altay-brusan/water-tank-telemeter/Hardware/Design/Water Tank Telemeter.html

Altium customize

# Board Information Report

Date: | | 7/1/2020
Time: | | 11:07:46 PM
Elapsed Time: | | 00:00:00
Filename: | | D:\[PieVision]\Sync\[PROJECTS]\Design Files\PieVision\WTT\V1I1\Water Tank Telemeter.PcbDoc

## Contents

Contents
