altay-brusan/water-tank-telemeter/Hardware/Design/Water Tank Telemeter.PcbDoc.htm

Reporting Options

# File in Previous Format

Date | : | 1/22/2021
Time | : | 12:21:04 PM
Filename | : | D:\embedded_systems\Projects\Pievision\WTT\Design\Water Tank Telemeter.PcbDoc

Version | Warning

This file was generated by an earlier version of the software
