altay-brusan/water-tank-telemeter/Hardware/Assets/Checkout order.docx

Check order:

1- Visual inspection

Rust

Dust

Corrosion

Components drop

Back plane

Water drops

2- 12V input ripple measurement with oscilloscope

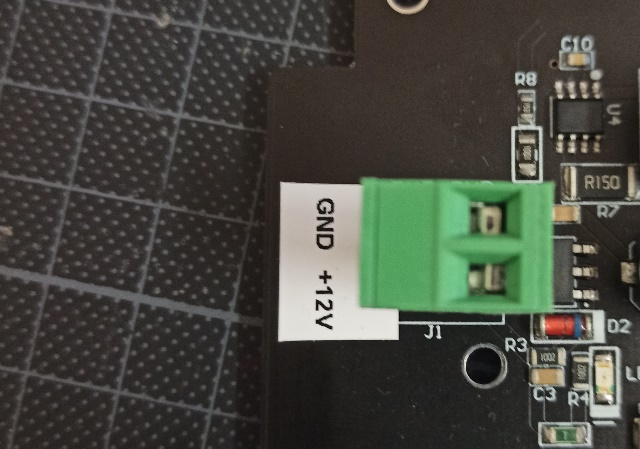
[picture p2: figure]

3- 3.3V 3.8V and 20V test point measurement

TP4: 20V

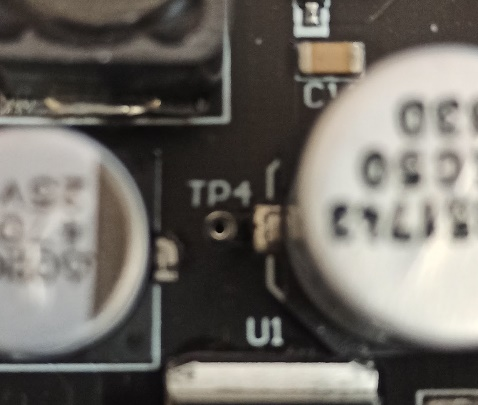
[picture p3: figure]

TP1: 5.3V TP2:3.8 TP3:3.3V

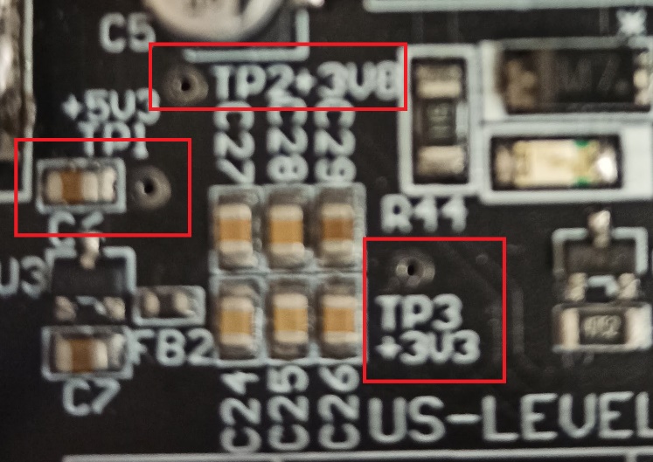
[picture p4: figure]

TP5: GND

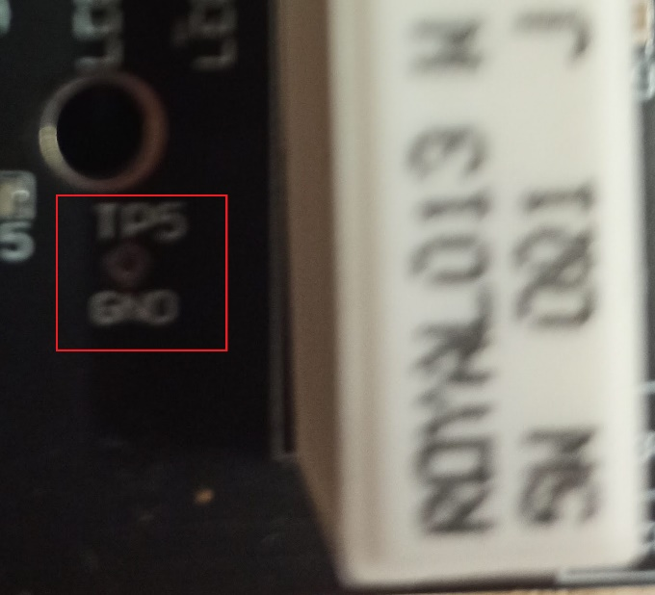
[picture p5: figure]

4- GOSUNCN external power: this pin should provide 2.7V

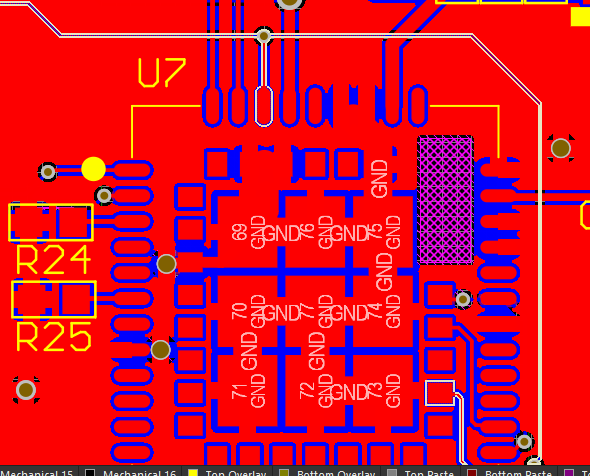
[picture p6: figure]

5- UART Monitoring

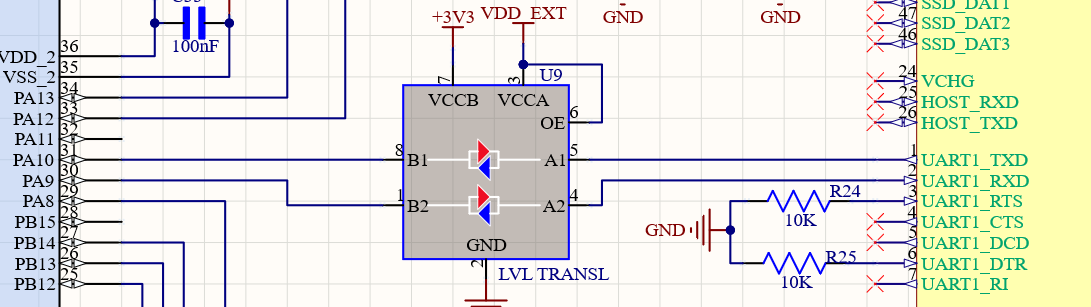
[picture p7: figure]
