altay-brusan/water-tank-telemeter/Hardware/Release/PCB Manufacturing/Water Tank Telemeter BOM.xlsx

Comment | Designator | Quantity | Product Name | Product Description | Footprint
100uF | C1, C13 | 2 | BXJ63VC100MJ10TP | CAP.EL.100uF 63V 10x10 105C 5000Hrs SMD | CAP_AL_1010
470uF | C2, C8 | 2 | BDS25VC470MJ10TP | CAP.EL.470uF 25V 10x10 105C 2000Hrs SMD ±20%, CAP.EL.470uF 25V 10x10 105C 2000Hrs SMD | CAP_AL_1010
10nF | C3, C14, C15, C16, C24, C25 | 6 | CL21C103JBFNNNE | MLCC (2012) 0805 10nF 50VDC ±5% C0G (NP0) | CAP_0805
330nF | C4 | 1 | CL21B334KOCNNNC | MLCC (2012) 0805 330nF 16VDC ±10% X7R | CAP_0805
10uF | C5 | 1 | SC1V106M05005VR | CAP.EL.10uF 35V 5x5.3 85C SMD SAMWHA | CAP_AL_0553
1uF | C6, C7, C18, C23, C29 | 5 | CL21F105ZBFNNNE | MLCC (2012) 0805 1uF 50VDC -20% +80% Y5V | CAP_0805
100nF | C9, C11, C26, C27, C28, C30, C33, C34, C35, C37, C38, C39, C40, C41, C42, C43, C44, C45, C46, C47, C48, C49 | 22 | CL21B104JBCNNNC | MLCC (2012) 0805 100nF 50VDC ±5% X7R | CAP_0805
2.2nF | C10 | 1 | CL21B222JBANNNC | MLCC (2012) 0805 2.2nF 50VDC ±5% X7R | CAP_0805
330uF | C12 | 1 | LQ1H337M10020PA | CAP.EL.330uF 50V 10x20 105C 10000H TB | CAP_AL_THT_10X20X5MM
33pF | C17 | 1 | CL21C330GBANNNC | MLCC (2012) 0805 33pF 50VDC ±2% C0G (NP0) | CAP_0805
100uF | C19 | 1 | T491B107K006AT | CAP.TANTAL 100uF 6.3V 10% B CASE (3528) SMD KEMET | CAP_TANT_CASEB
1000uF | C20 | 1 | BXJ6.3VC1000MH10TP | CAP.EL.1000uF 6V3 8x10 105C 5000Hrs SMD | CAP_AL_0810
22pF | C21, C22 | 2 | CL21C220JBANNNC | MLCC (2012) 0805 22pF 50VDC ±5% C0G (NP0) | CAP_0805
20pF | C31, C32 | 2 | CL21C200JBANNNC | MLCC (2012) 0805 20pF 50VDC ±5% C0G (NP0) | CAP_0805
4.7uF | C36 | 1 | CL21A475KAQNNNE | MLCC (2012) 0805 4.7uF 25VDC ±10% X5R | CAP_0805
S6M | D1, D8 | 2 | S6M-DC | DIODE 6A 1000V SMT DO214AB (SMC) | DO-214AB
ZM4740 | D2, D3, D4 | 3 | ZM4740A-HT | DIODE ZENER 1W 10V ±5% LL-41 (MELF) SMT | MELF
SR35_R2_00001 | D5 | 1 | SR35_R2_00001 | DIODE SCHOTTKY 3A 50V DO214AA SMB PANJIT | DO214AA
B5819 | D6 | 1 | B5819W | DIODE SCHOTTKY 1A 40V SOD123 | SOD123
ZM4751 | D7 | 1 | ZM4751A-HT | DIODE ZENER 1W 30V ±5% LL-41 (MELF) SMT | MELF
M7_R2_00001 | D17, D18, D19, D20 | 4 | M7_R2_00001 | DIODE STAND. Single 1A 1000V SMT DO214AC (SMA) | DID_SMA
SM05T1G | D21, D22, D23, D24 | 4 | SM05T1G | DIODE TVS 5VWM 9.8VC SOT23 | SOT-23
1206SFS600F | F1, F2 | 2 | 1206SFS600F/24-2 | FUSE BOARD MOUNT 6A 24VDC 1206 | FUS_1206
33R | FB1, FB2, FB3, FB5 | 4 | BLM18PG330SN1D | FERRITE BEAD 0603 33R 3A MURATA | FB_0603
KF2EDG | J1, J2, J3 | 3 | KF2EDG-5.08-2P-14 | TERM.BLK.5.08MM 2P FEMALE GREEN | TERM_BLK_2P_F
SMA | J4 | 1 | L-KLS1-SMA045 | CONNECTOR SMA 5PIN THT R/A 8x8x14.8MM | CONN_SMA_H
Nano SIM Card Connector, Push & Pull | J5 | 1 | 115U-A000 | CONNECTOR NANO SIM CARD PUSH PULL 6PIN H:1.2MM | SOC_NSIM
Screw Ter. Blk. | J6, J7 | 2 | GT301-5.0-12P-12-00AH | TERM.BLK.5.00MM 12P PCB TYPE | TERM_BLK_12P
JW2SN | K1, K2, K3, K4 | 4 | JW2SN-DC12V | RELAY POWER 5A 12VDC 2P PANASONIC | RELAY_DPDT
100uH | L1, L2 | 2 | SRI1207-101M | INDUCTOR POWER 100UH 12X12X8MM SMD | IND_1212
HL-PC | LED1, LED2, LED3, LED5, LED8, LED9, LED10, LED11 | 8 | HL-PC-3216S9AC | LED SMD 1206 RED WATER CLEAR 90-120 mcd 140C | LED_RED_1206
HL-PC | LED4, LED7 | 2 | HL-PC-3216U51GC | LED SMD 1206 GREEN WATER CLEAR 600-800mcd | LED_GREEN_1206
HL-PC | LED6 | 1 | HL-PC-3216S29YC | LED SMD 1206 YELLOW WATER CLEAR 90-120mcd 140C | LED_YELLOW_1206
HDR_4X2 | P1 | 1 |  | Header, 4-Pin, Dual row | HDR2X4
MIC Connector | P2 | 1 |  |  | CONN_MIC_5P
NDT3055L | Q1, Q2, Q3 | 3 | NDT3055L | MOSFET DIS.4A 60V N-CH SOT223 ENHANCEMENT SMT | SOT223
BC327 | Q4 | 1 | BC327-40ZL1G | TRANSISTOR DIS.500mA 50V PNP TO92 AMP THT TRANSISTOR DIS.500mA 50V PNP TO92 AMP THT | TO-92
UTM2054G | Q5, Q6, Q7 | 3 | UTM2054G-AE3-R | MOSFET DIS.5A 20V N-CH SOT23 ENHANCEMENT SMT | SOT-23
ZXMN3A | Q9, Q10, Q11, Q12 | 4 | ZXMN3A01FTA | MOSFET DIS.1.8A 30V N-CH SOT23 ENHANCEMENT SMT | SOT-23
1K | R1, R6 | 2 | 0805S8F1001T5E, 0805S8J0102T5E | RES.(2012) 0805 1K Ohms 1% 1/8W-S 100PPM, RES.(2012) 0805 1K Ohms 5% 1/8W-S 100PPM | RES_0805
3.3K | R2 | 1 | 0805S8F3301T5E | RES.(2012) 0805 3.3K Ohms 1% 1/8W-S 100PPM | RES_0805
10K | R3, R4, R20, R21, R22, R24, R25, R34 | 8 | 0805S8F1002T5E, 0805S8J0103T5E | RES.(2012) 0805 10K Ohms 1% 1/8W-S 100PPM, RES.(2012) 0805 10K Ohms 5% 1/8W-S 100PPM | RES_0805
2.1K | R5 | 1 | 0805S8F2101T5E | RES.(2012) 0805 2.1K Ohms 1% 1/8W-S 100PPM | RES_0805
150mR | R7 | 1 | HP122WF150LT4E | RES.(6432) 2512 150m Ohms 1% 2W 200PPM | RES_2512
15K | R8 | 1 | 0805S8J0153T5E | RES.(2012) 0805 15K Ohms 5% 1/8W-S 100PPM | RES_0805
1K | R9 | 1 | 1206S4F1001T5E | RES.(3216) 1206 1K Ohms 1% 1/4W-S 100PPM | RES_1206
100R | R10 | 1 | PRW05WJP101B00 | RES.CEMENT 5W 100 Ohms 5% THT | RES_AXL_22X9
3.3R | R11 | 1 | RC2012F3R3CS | RES.(2012) 0805 3.3 Ohms 1% 1/8W +300PPM~-200PPM | RES_0805
220R | R12 | 1 | ERJ-P06D2200V | RES.(2012) 0805 220 Ohms 0.5% 1/2W 100PPM | RES_0805
2.7K | R13 | 1 | 0805S8F2701T5E | RES.(2012) 0805 2.7K Ohms 1% 1/8W-S 100PPM | RES_0805
1.5K | R14 | 1 | 0805S8F1501T5E | RES.(2012) 0805 1.5K Ohms 1% 1/8W-S 100PPM | RES_0805
100R | R15 | 1 | 0805S8F1000T5E | RES.(2012) 0805 100 Ohms 1% 1/8W-S 200PPM | RES_0805
4.7K | R16, R17 | 2 | 0805S8J0472T5E | RES.(2012) 0805 4.7K Ohms 5% 1/8W-S 100PPM | RES_0805
1.8K | R18, R19 | 2 | 0805S8J0182T5E | RES.(2012) 0805 1.8K Ohms 5% 1/8W-S 100PPM | RES_0805
49.9R | R23 | 1 | TC0325D499JT5C | RES.(1608) 0603 49.9 Ohms 0.5% 1/16W 25PPM | RES_0603
22R | R26, R27, R28 | 3 | CQ05S8F220JT5E | RES.(2012) 0805 22 Ohms 1% 1/8W-S AUTOMOTIV | RES_0805
47.5K | R29, R30, R35, R37, R38, R39, R40 | 7 | 0805S8F4752T5E | RES.(2012) 0805 47.5K Ohms 1% 1/8W-S 100PPM | RES_0805
150R | R31, R32 | 2 | 0805S8J0151T5E | RES.(2012) 0805 150 Ohms 5% 1/8W-S 100PPM | RES_0805
130R | R33, R45, R46, R47, R48, R49, R50, R51, R52 | 9 | 0805S8J0131T5E | RES.(2012) 0805 130 Ohms 5% 1/8W-S 100PPM | RES_0805
510R | R41, R42, R43, R44 | 4 | 1206S4J0511T5E | RES.(3216) 1206 510 Ohms 5% 1/4W-S 100PPM | RES_1206
200R | R53, R54, R55, R56, R57, R58, R59, R60 | 8 | CQ06W4F2000T5E | RES.(3216) 1206 200 Ohms 1% 1/4W-S AUTOMOTIV | RES_1206
330R | R61, R62, R63, R64, R65, R66, R67, R68 | 8 | CQ06W4F3300T5E | RES.(3216) 1206 330 Ohms 1% 1/4W-S AUTOMOTIV | RES_1206
SWC | SW1 | 1 | DTSMF-31R-V-T/R | SWITCH TACT 6x3.5MM 4.3MM 260gf SMD DIPTRONICS | TAC_0603_VT
P2576L-ADJ | U1 | 1 | P2576L-AD-TQ5-R | IC-2576 V.REG.3A ADJ SIMPL.STEP-DOWN SMD TO-263 | TO170P1435X465-6N
LD29300 | U2 | 1 | LD29300P2MTR | IC-29300 REG. LDO. ADJ 3A P2PAK/A | D2PAK/A
3.3V | U3 | 1 | MCP1700T-3302E/TT | IC-1700 REG LDO 3.3V 0.25A SOT23-3 | SOT-23
NCV3063 | U4 | 1 | NCV3063DR2G | IC-3063 INV. SWITCHING REGULATORS SOIC8 SMD ONS | SOIC-8
LM317T | U5 | 1 | LM317T-DG | IC-317 V.REG/STABILIZER 1.5A TO220 DOUBLE GAUG ST | TO-220AB
TL071CDR | U6 | 1 | TL071CDR | IC-071 OPAMP JFET 3MHZ SOIC8 | SOIC-8
MG2609 | U7 | 1 | HZ-MG2609-C1B-MK-01 | MODULE GSM/GPRS + ( OPTIONAL )GNSS | LCC_17P6X15P7X2P3
STM32F103C8T7 | U8 | 1 | STM32F103C8T7TR |  | LQFP-48
LVL TRANSL | U9 | 1 | TXB0102DCUR | IC-102 VOLT-LVL TRANSL BI-DIR US8 | VSSOP8
ESDA6V | U10 | 1 | ESDA6V1BC6 | DIODE TVS 80W 5V SOT23 SMD | SOT23-6L
ST3222BTR | U11 | 1 | ST3222BTR | IC-3222 DRIVER/RCVR RS232 LP 20-TSSOP | TSSOP20
LTV-217 | U12, U13, U14, U15, U16, U17, U18, U19 | 8 | LTV-217-B-G | IC-217 OPTO. 3750V SSOP4 | SSOP-4
8MHZ | Y1 | 1 | AS-8.000-20-H35 | CRYSTAL 8MHZ HC49S 20pF 30ppm SHORT BULK RALTRON | CRYS_THT
