altay-brusan/water-tank-telemeter/Hardware/Design/Project Outputs for Water Tank Telemeter/Water Tank Telemeter.xlsx

Comment | Designator | Footprint | LibRef | Quantity
100uF | C1, C13 | CAP_AL_1010 | CAP_AL_1010 | 2
470uF | C2, C8 | CAP_AL_1010 | CAP_AL_1010 | 2
10nF | C3, C14, C15, C16, C24, C25 | CAP_0805 | CAP_0805 | 6
330nF | C4 | CAP_0805 | CAP_0805 | 1
10uF | C5 | CAP_AL_0553 | CAP_AL_0553 | 1
1uF | C6, C7, C18, C23, C29 | CAP_0805 | CAP_0805 | 5
100nF | C9, C11, C26, C27, C28, C30, C33, C34, C35, C37, C38, C39, C40, C41, C42, C43, C44, C45, C46, C47, C48, C49 | CAP_0805 | CAP_0805 | 22
2.2nF | C10 | CAP_0805 | CAP_0805 | 1
330uF | C12 | CAP_AL_THT_10X20X5MM | CAP_AL_THT_10X12X5MM | 1
33pF | C17 | CAP_0805 | CAP_0805 | 1
100uF | C19 | CAP_TANT_CASEB | CAP_TANT_CASEB | 1
1000uF | C20 | CAP_AL_0810 | CAP_AL_0810 | 1
22pF | C21, C22 | CAP_0805 | CAP_0805 | 2
20pF | C31, C32 | CAP_0805 | CAP_0805 | 2
4.7uF | C36 | CAP_0805 | CAP_0805 | 1
S6M | D1, D8 | DO-214AB | DID_DO214 | 2
ZM4740 | D2, D3, D4 | MELF | DID_ZEN_MELF | 3
SR35_R2_00001 | D5 | DO214AA | D_SCK_DO214AA | 1
B5819 | D6 | SOD123 | DID_SCHK_SOD123 | 1
ZM4751 | D7 | MELF | DID_ZEN_MELF | 1
M7_R2_00001 | D17, D18, D19, D20 | DID_SMA | DID_SMA | 4
SM05T1G | D21, D22, D23, D24 | SOT-23 | TVS_SOT23 | 4
1206SFS600F | F1, F2 | FUS_1206 | FUZ_SMD_1206 | 2
33R | FB1, FB2, FB3, FB5 | FB_0603 | FB_0603 | 4
KF2EDG | J1, J2, J3 | TERM_BLK_2P_F | TERM_BLK_2POS_F | 3
SMA | J4 | CONN_SMA_H | SMA_RA | 1
Nano SIM Card Connector, Push & Pull | J5 | SOC_NSIM | SOC_NSIM | 1
Screw Ter. Blk. | J6, J7 | TERM_BLK_12P | TERM_BLK_12POS | 2
JW2SN | K1, K2, K3, K4 | RELAY_DPDT | REL_DPDT_12V | 4
100uH | L1, L2 | IND_1212 | IND_1212 | 2
HL-PC | LED1, LED2, LED3, LED5, LED8, LED9, LED10, LED11 | LED_RED_1206 | LED_RED_1206 | 8
HL-PC | LED4, LED7 | LED_GREEN_1206 | LED_GREEN_1206 | 2
HL-PC | LED6 | LED_YELLOW_1206 | LED_YELLOW_1206 | 1
HDR_4X2 | P1 | HDR2X4 | HDR_4X2 | 1
MIC Connector | P2 | CONN_MIC_5P | CONN_MIC_5P | 1
NDT3055L | Q1, Q2, Q3 | SOT223 | MOSFET_N_SOT223 | 3
BC327 | Q4 | TO-92 | BJT_PNP_THT_CBE | 1
UTM2054G | Q5, Q6, Q7 | SOT-23 | MOSFET_N_SOT23 | 3
ZXMN3A | Q9, Q10, Q11, Q12 | SOT-23 | MOSFET_N_SOT23 | 4
1K | R1, R6 | RES_0805 | RES_0805 | 2
3.3K | R2 | RES_0805 | RES_0805 | 1
10K | R3, R4, R20, R21, R22, R24, R25, R34 | RES_0805 | RES_0805 | 8
2.1K | R5 | RES_0805 | RES_0805 | 1
150mR | R7 | RES_2512 | RES_2512 | 1
15K | R8 | RES_0805 | RES_0805 | 1
1K | R9 | RES_1206 | RES_1206 | 1
100R | R10 | RES_AXL_22X9 | RES_AXL_20X9 | 1
3.3R | R11 | RES_0805 | RES_0805 | 1
220R | R12 | RES_0805 | RES_0805 | 1
2.7K | R13 | RES_0805 | RES_0805 | 1
1.5K | R14 | RES_0805 | RES_0805 | 1
100R | R15 | RES_0805 | RES_0805 | 1
4.7K | R16, R17 | RES_0805 | RES_0805 | 2
1.8K | R18, R19 | RES_0805 | RES_0805 | 2
49.9R | R23 | RES_0603 | RES_0603 | 1
22R | R26, R27, R28 | RES_0805 | RES_0805 | 3
47.5K | R29, R30, R35, R37, R38, R39, R40 | RES_0805 | RES_0805 | 7
150R | R31, R32 | RES_0805 | RES_0805 | 2
130R | R33, R45, R46, R47, R48, R49, R50, R51, R52 | RES_0805 | RES_0805 | 9
510R | R41, R42, R43, R44 | RES_1206 | RES_1206 | 4
200R | R53, R54, R55, R56, R57, R58, R59, R60 | RES_1206 | RES_1206 | 8
330R | R61, R62, R63, R64, R65, R66, R67, R68 | RES_1206 | RES_1206 | 8
SWC | SW1 | TAC_0603_VT | TACT_SMD_VT_6MM | 1
P2576L-ADJ | U1 | TO170P1435X465-6N | P2576L-AD-TQ5-R | 1
LD29300 | U2 | D2PAK/A | LD29300 | 1
3.3V | U3 | SOT-23 | MCP1700 | 1
NCV3063 | U4 | SOIC-8 | NCV3063DR2G | 1
LM317T | U5 | TO-220AB | LM317T | 1
TL071CDR | U6 | SOIC-8 | TL071CDR | 1
MG2609 | U7 | LCC_17P6X15P7X2P3 | MG2609 | 1
STM32F103C8T7 | U8 | LQFP-48 | STM32F103C8T7 | 1
LVL TRANSL | U9 | VSSOP8 | TXB0102DCUR | 1
ESDA6V | U10 | SOT23-6L | TVS_SOT236 | 1
ST3222BTR | U11 | TSSOP20 | TRANS_RS232 | 1
LTV-217 | U12, U13, U14, U15, U16, U17, U18, U19 | SSOP-4 | OPTCOP | 8
8MHZ | Y1 | CRYS_THT | CRYS-THT | 1
