altay-brusan/water-tank-telemeter/Hardware/Release/Schematic Diagrams/schematics.PDF

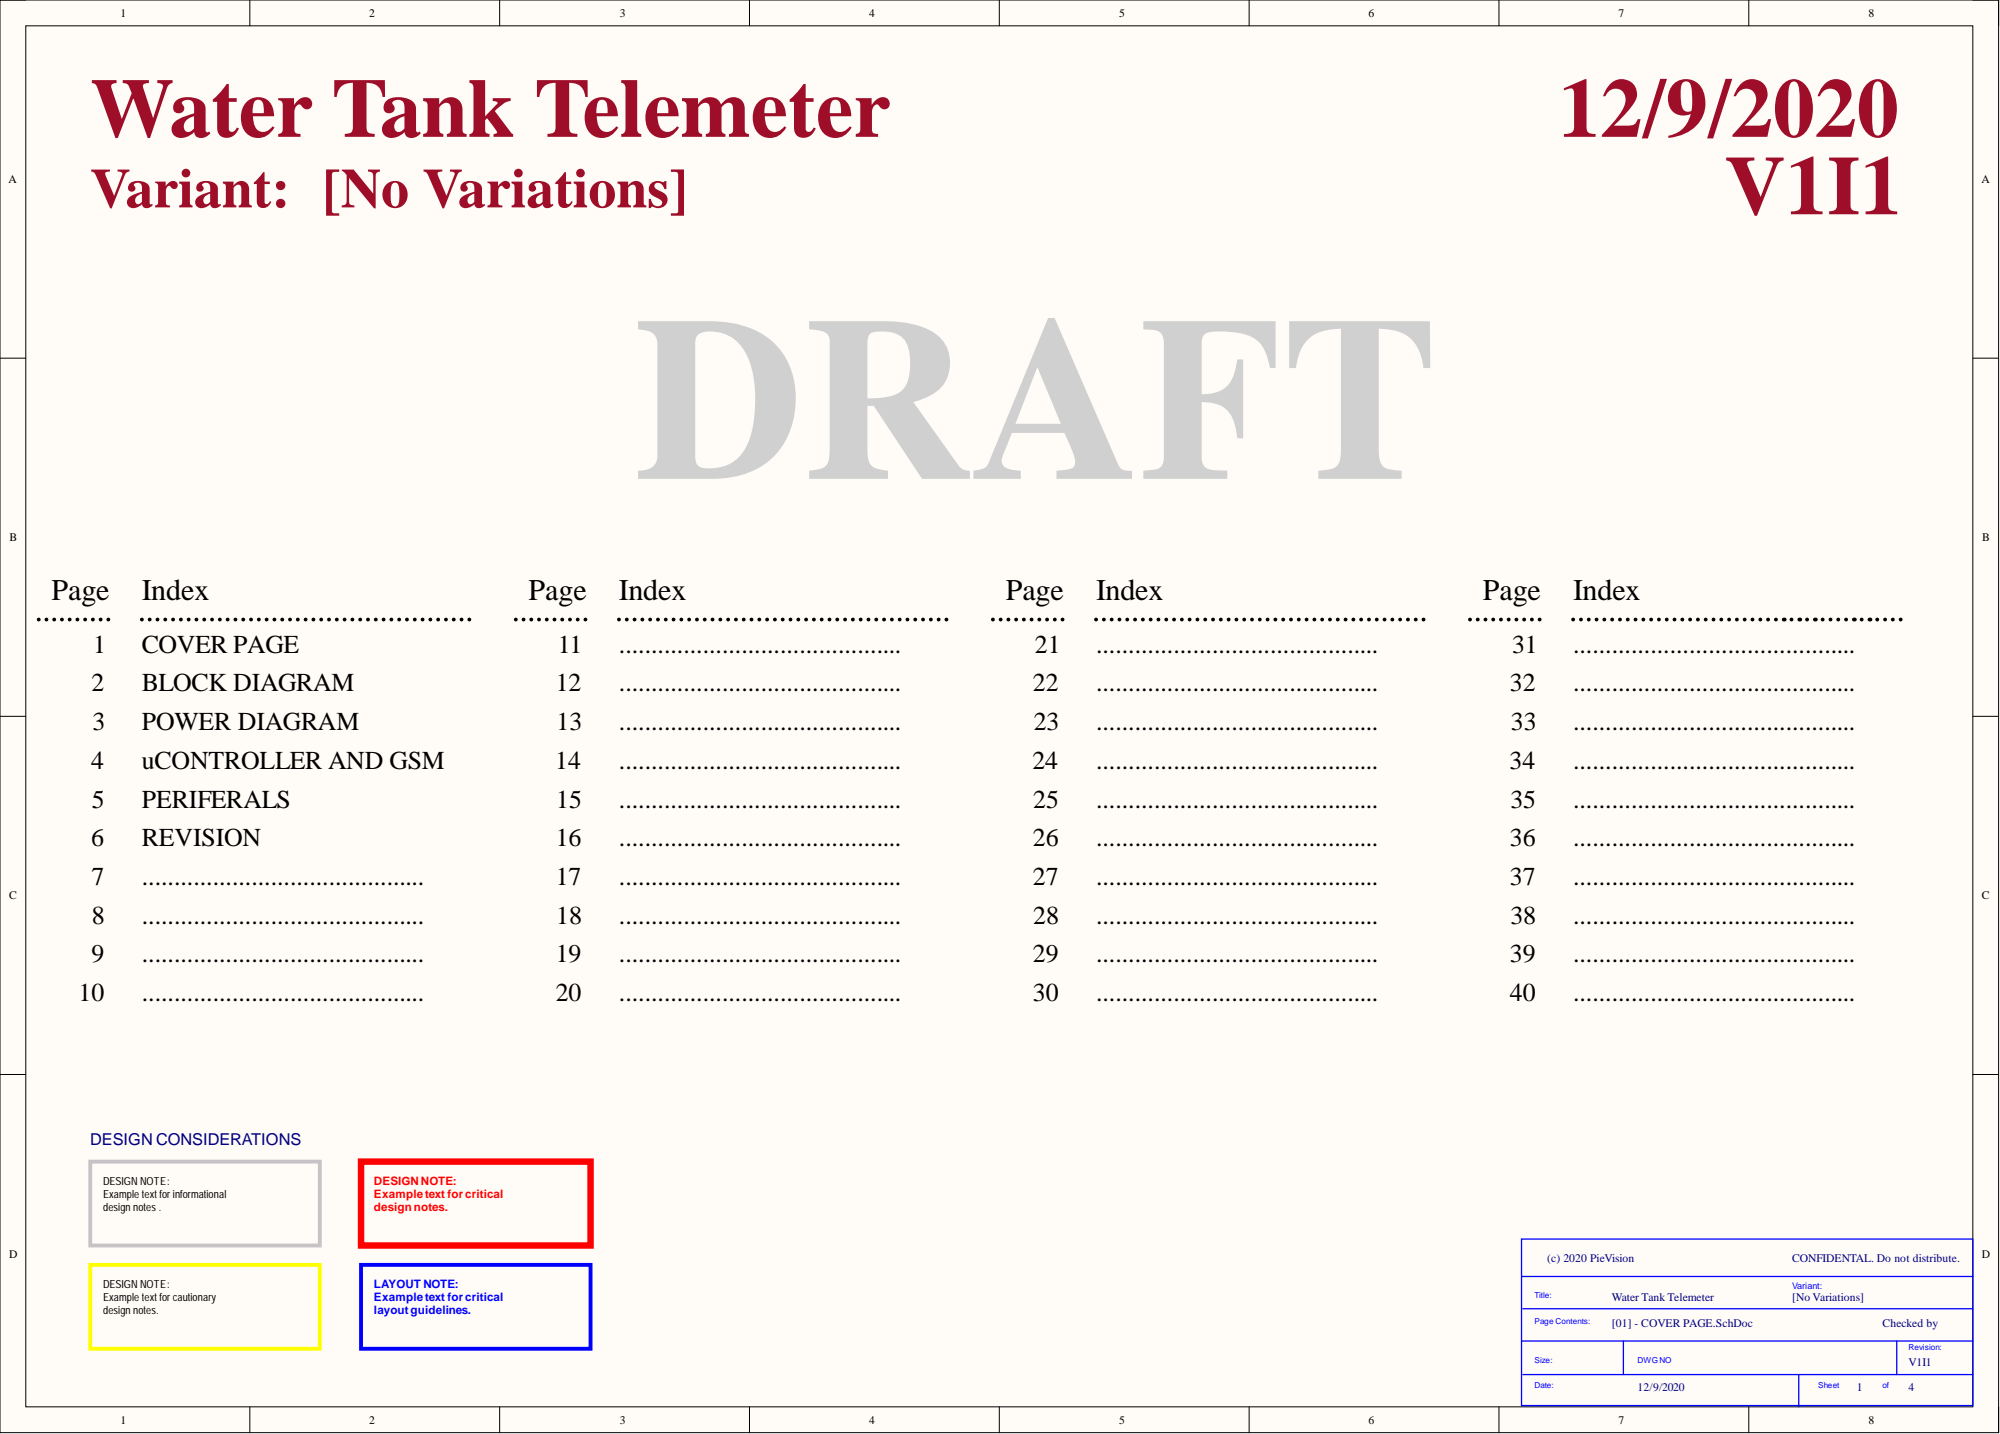
[picture p8: page 1]

DESIGN NOTE:
Example text for informational
design notes .

Example text for critical
design notes.

CONFIDENTAL. Do not distribute.

Example text for cautionary

LAYOUT NOTE:
layout guidelines.

Size: | DWG NO | Revision: V1I1

Date: | Sheet of

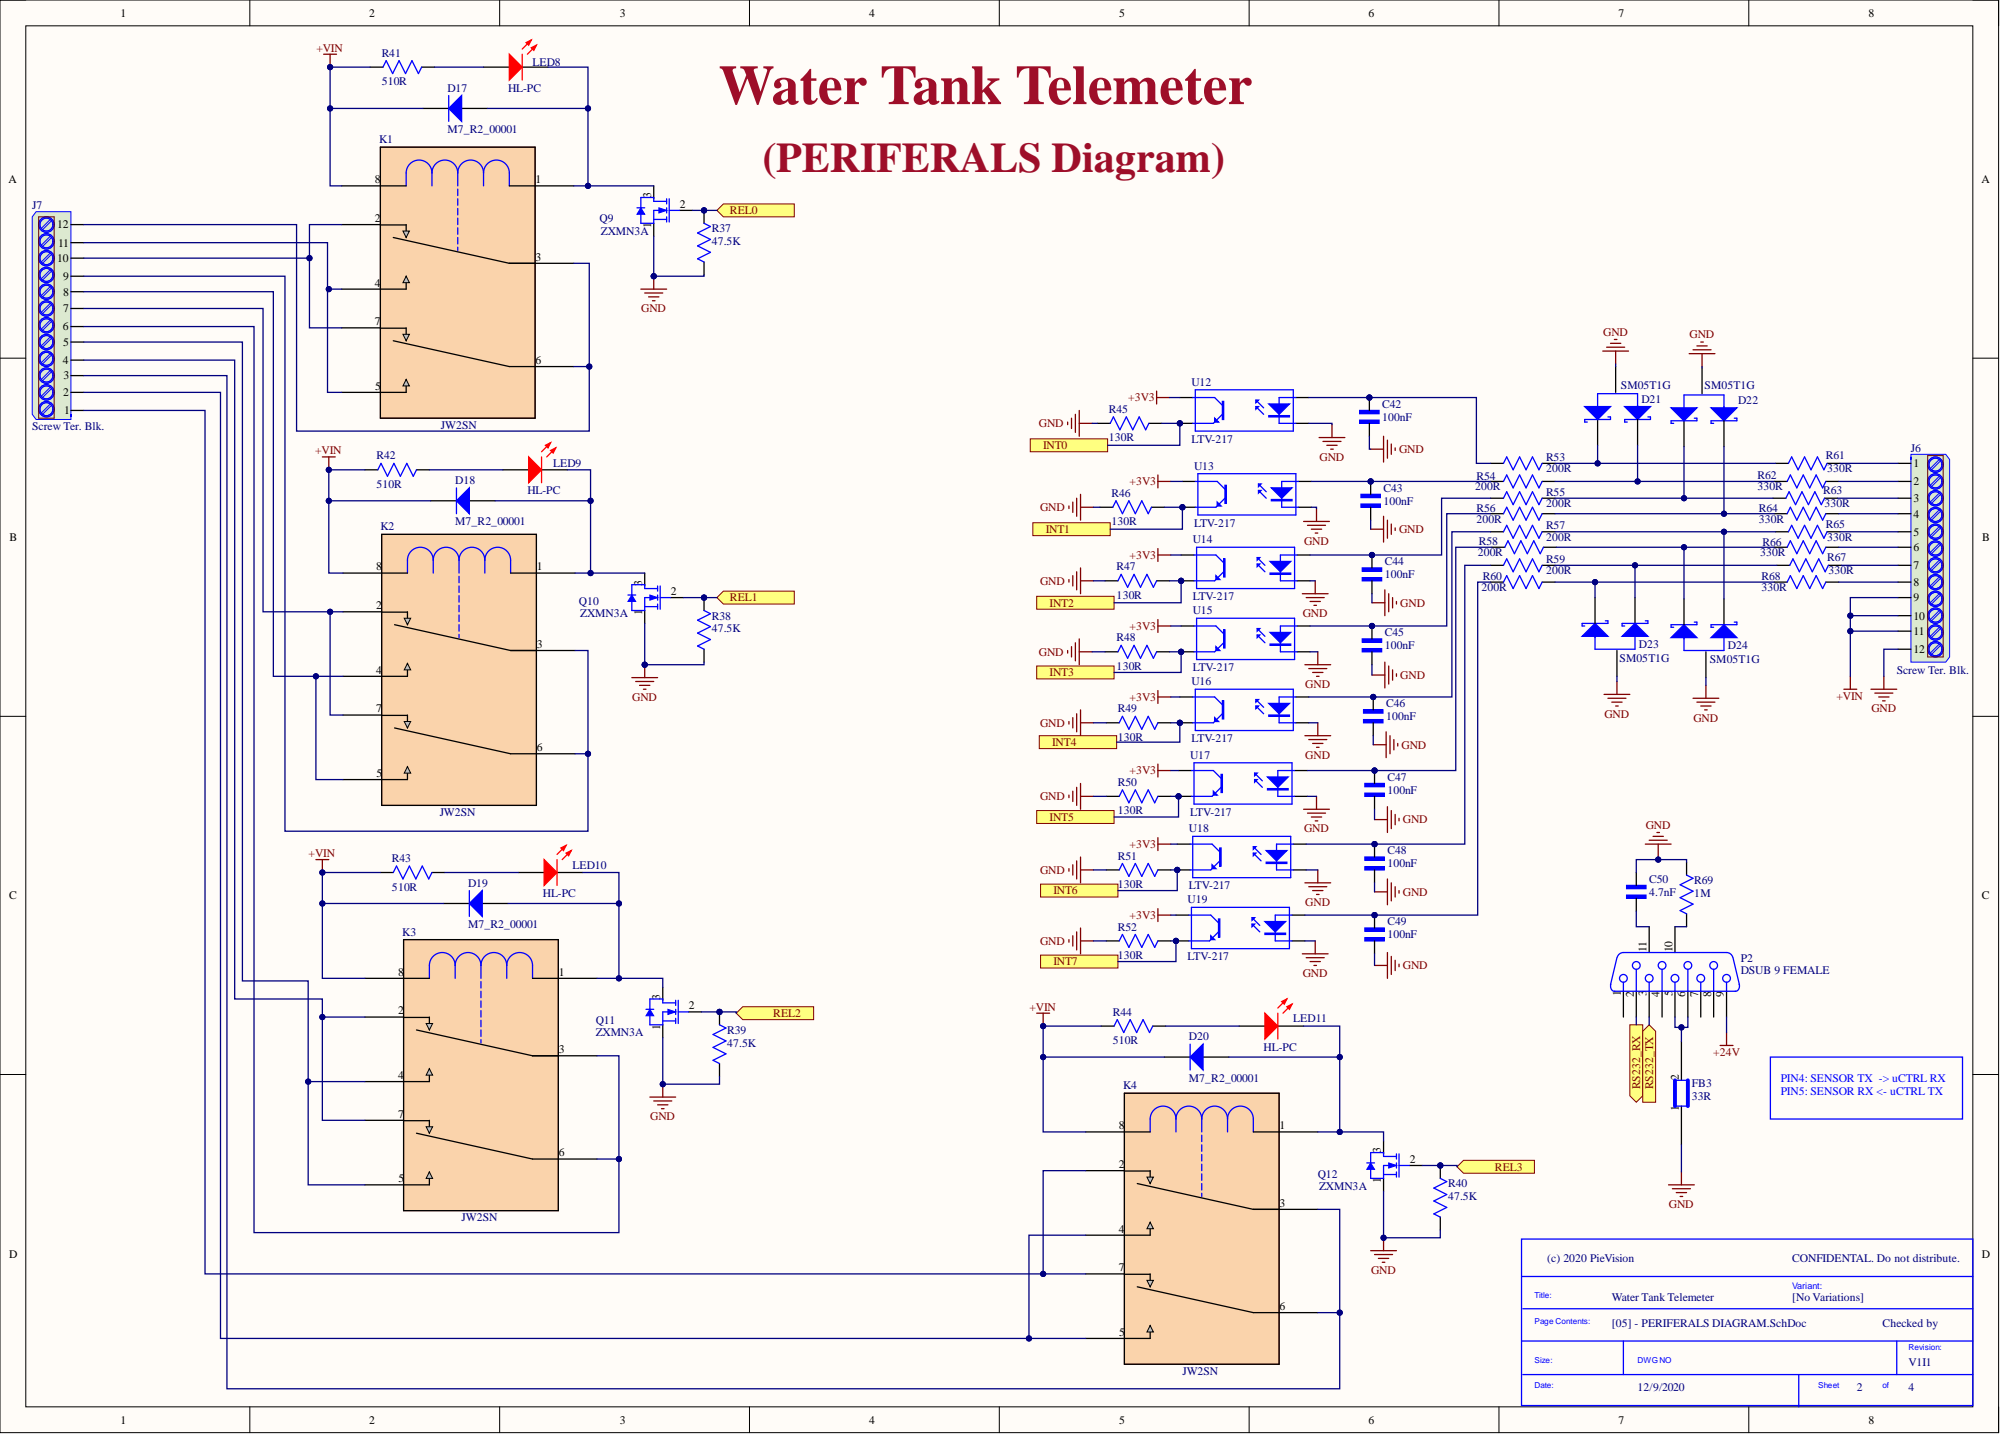
[picture p9: page 2]

C4 4
1 0 0 n F

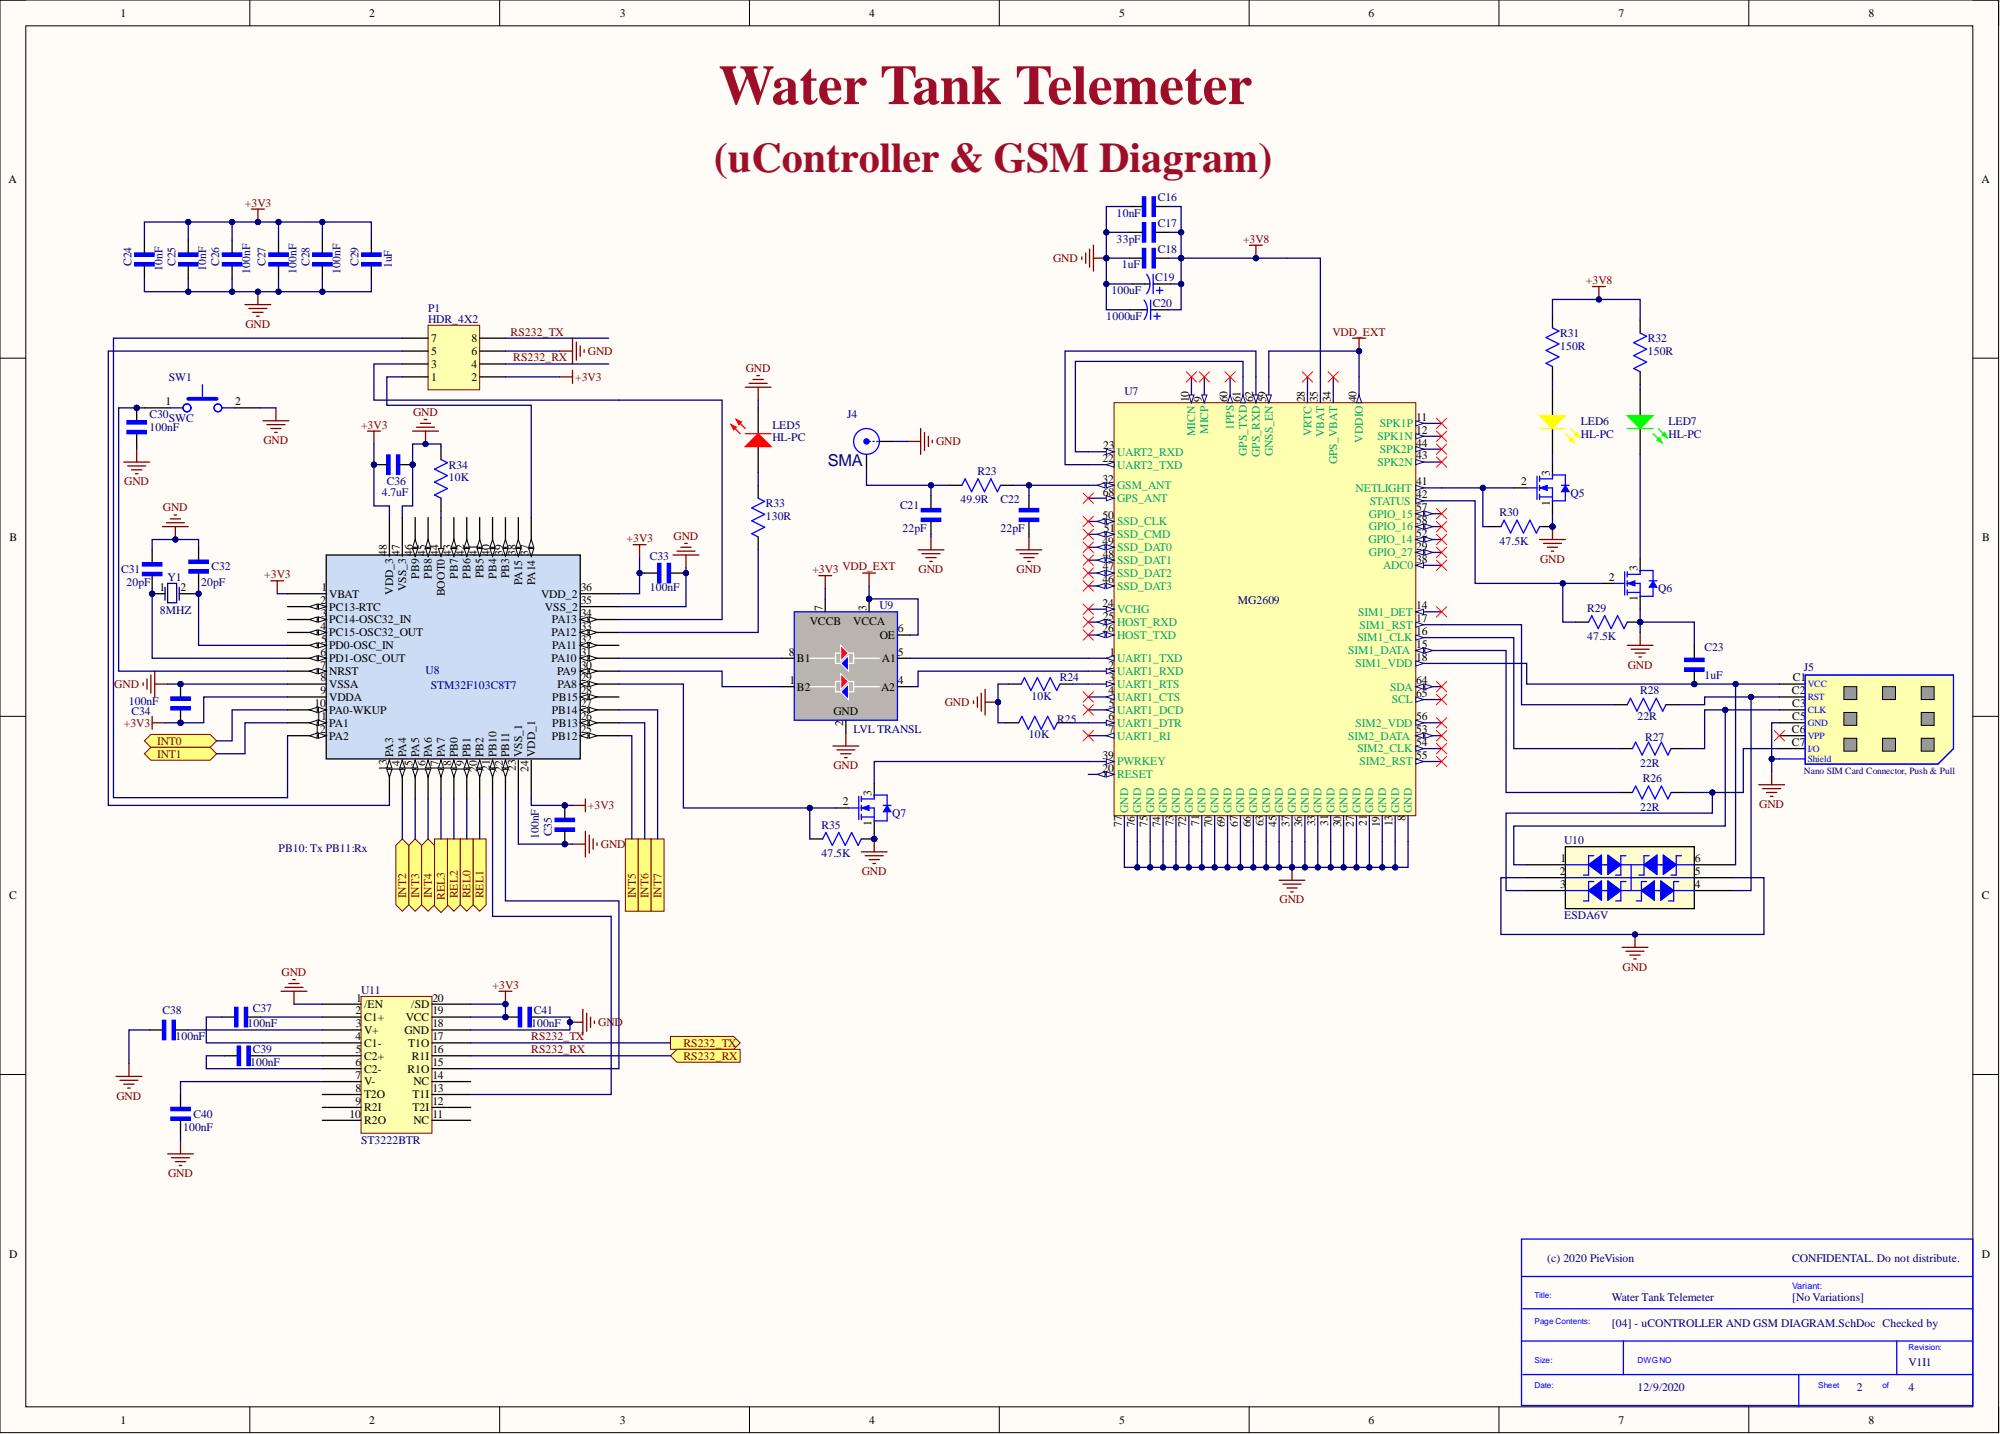
[picture p10: page 3]

PC13-RTC 2

Shield
Nano SIM Card Connector, Push & Pull

C39 | | RS232_RX
100nF | C2- 6

CONFIDENTAL. Do not distribute.

[04] - uCONTROLLER AND GSM DIAGRAM.SchDoc

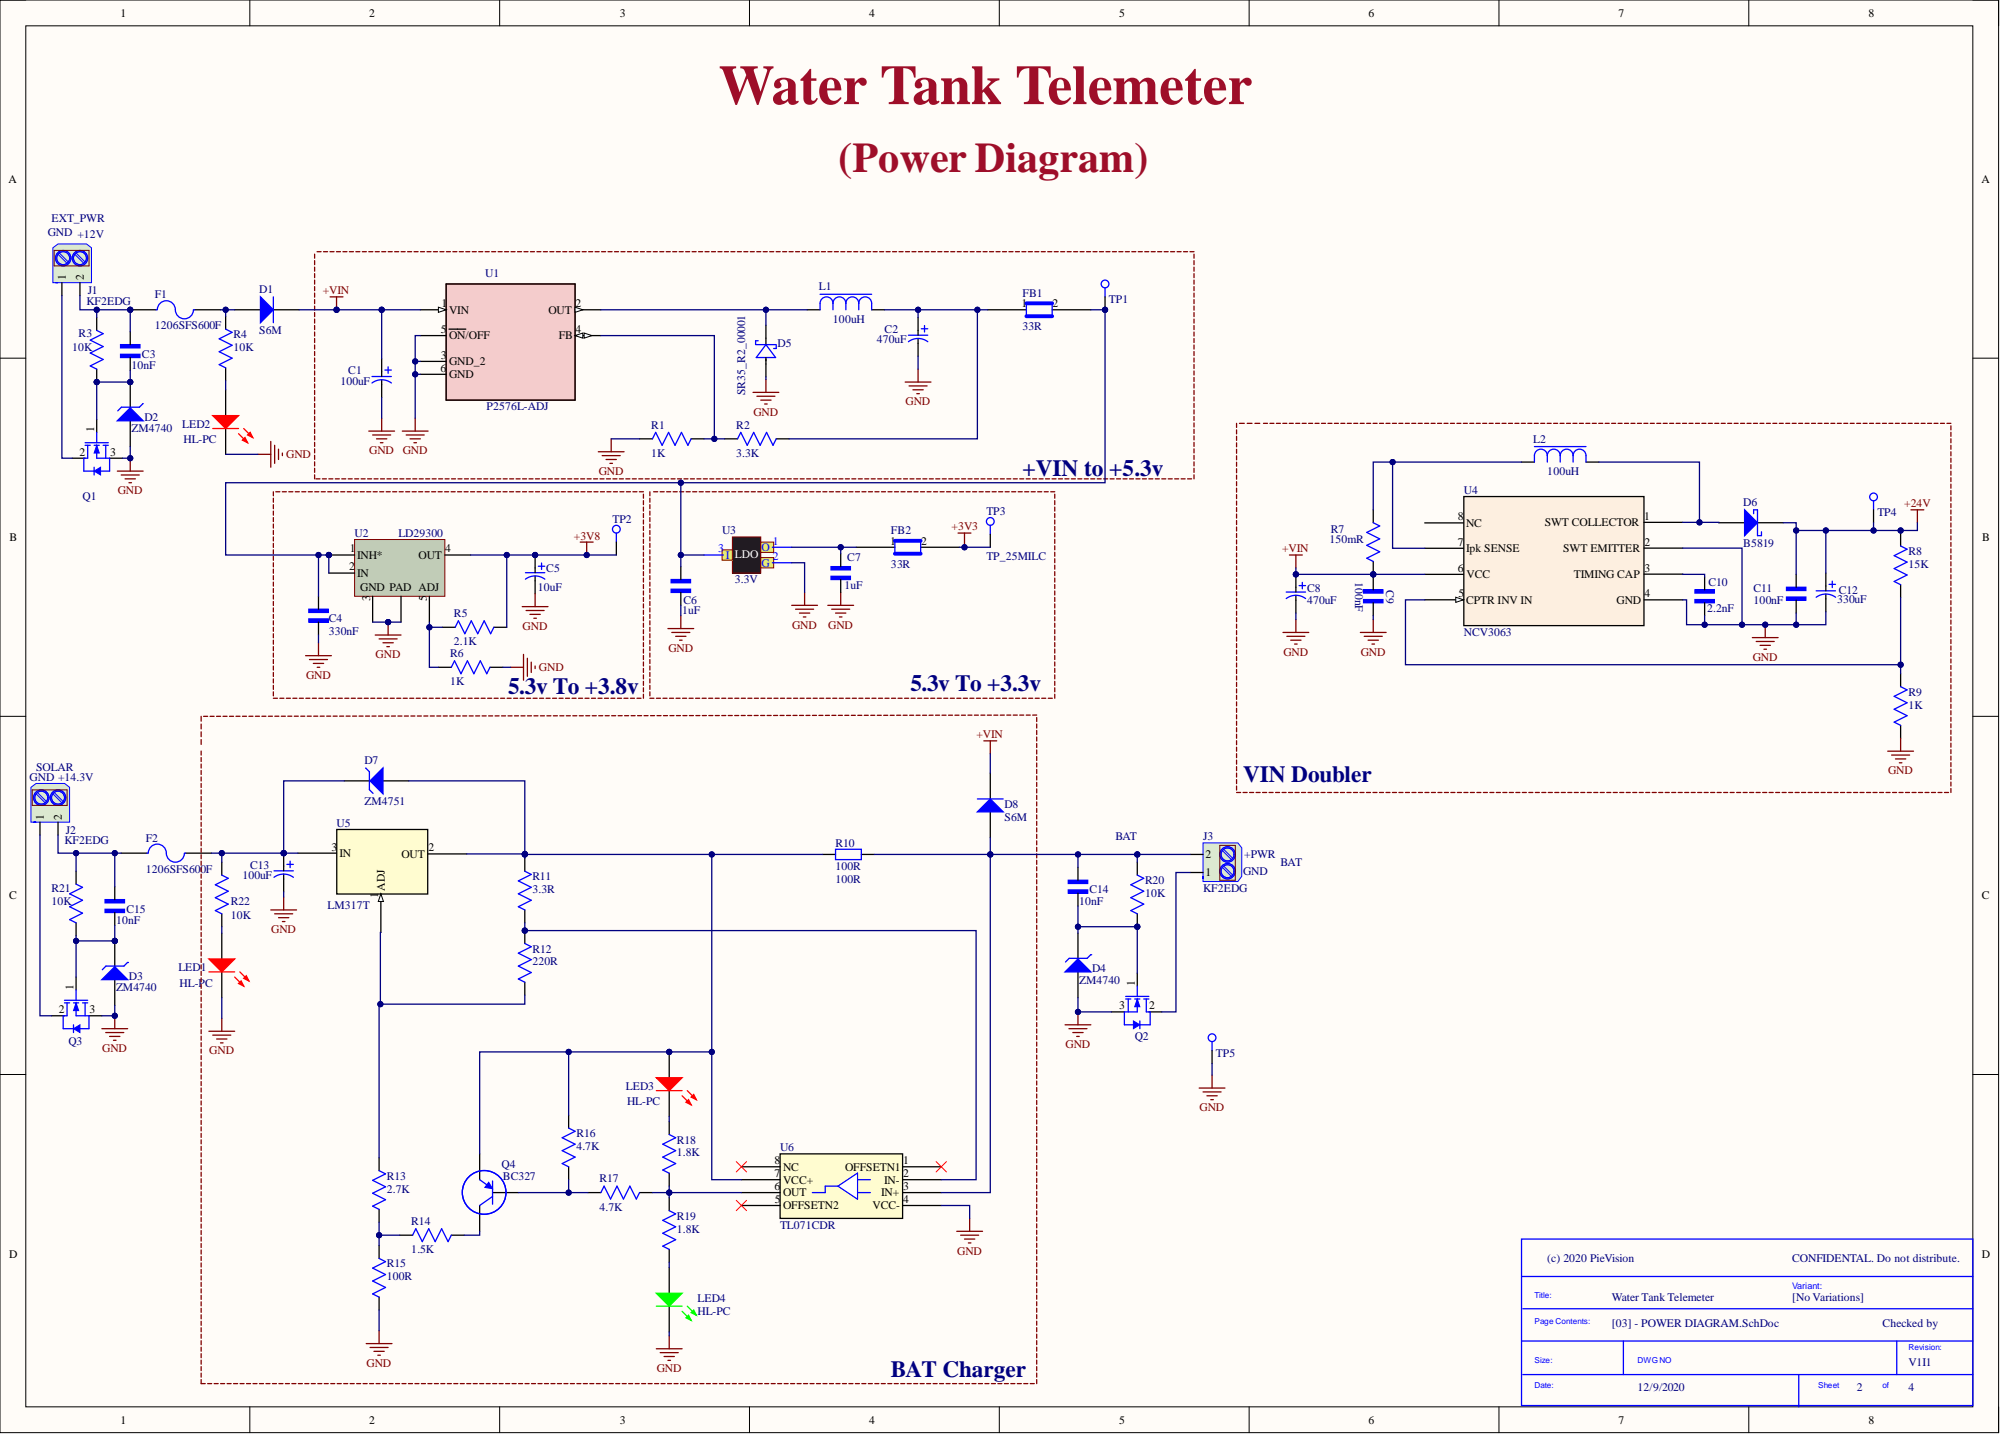
[picture p11: page 4]

8 | Ip k SE NSE VCC

N C OFFSE | T N 1 IN -
OFFSE T N 2 | | 3

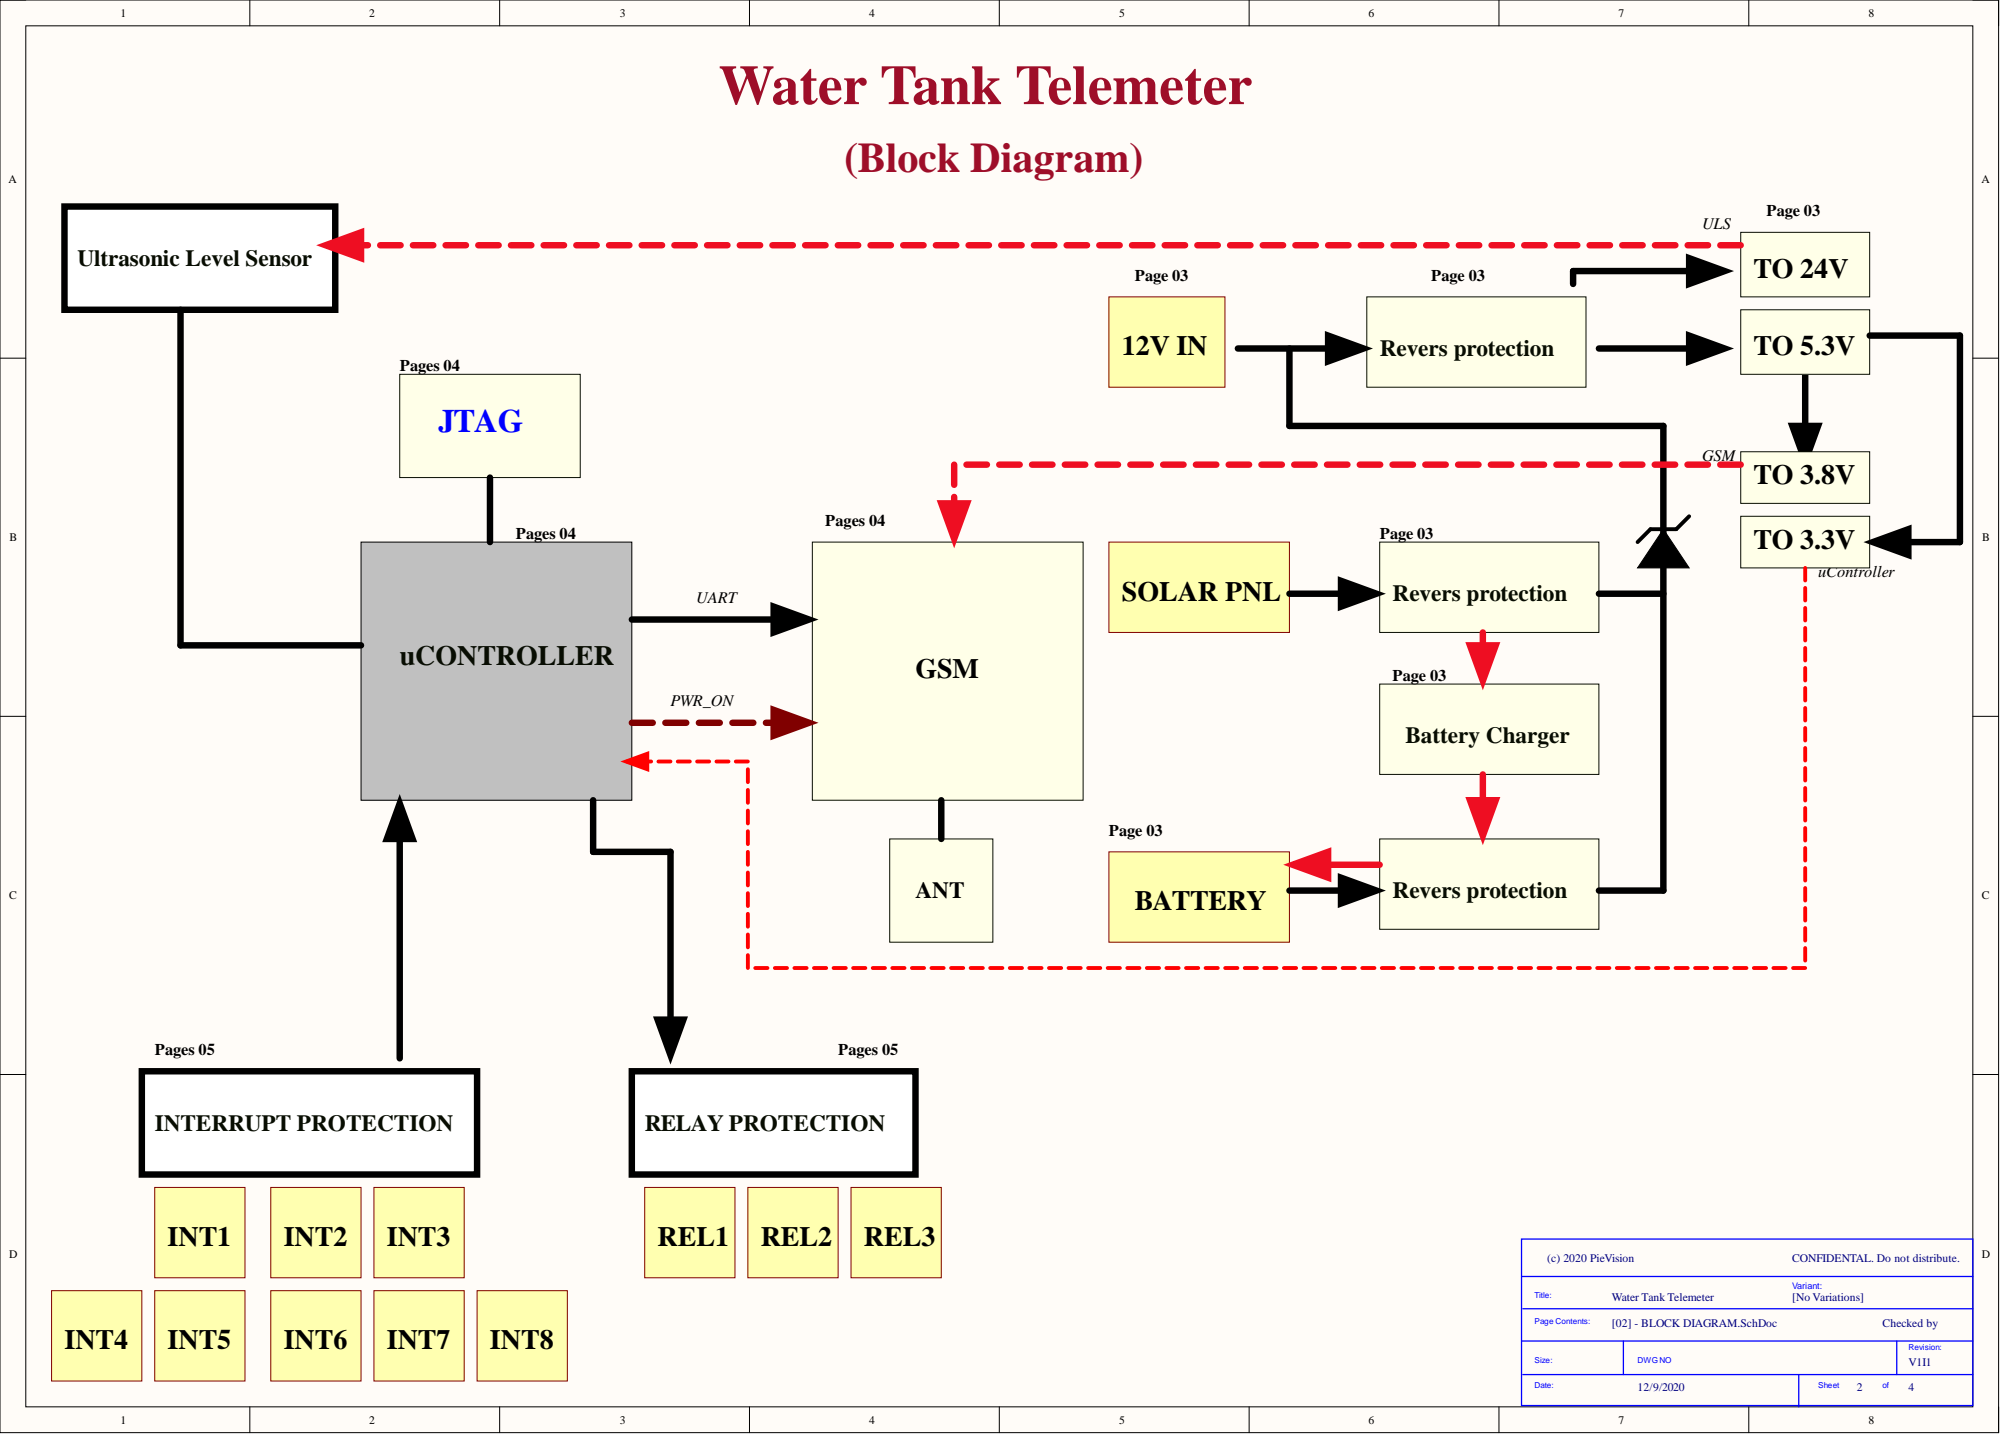
[picture p12: page 5]

CONFIDENTAL. Do not distribute.

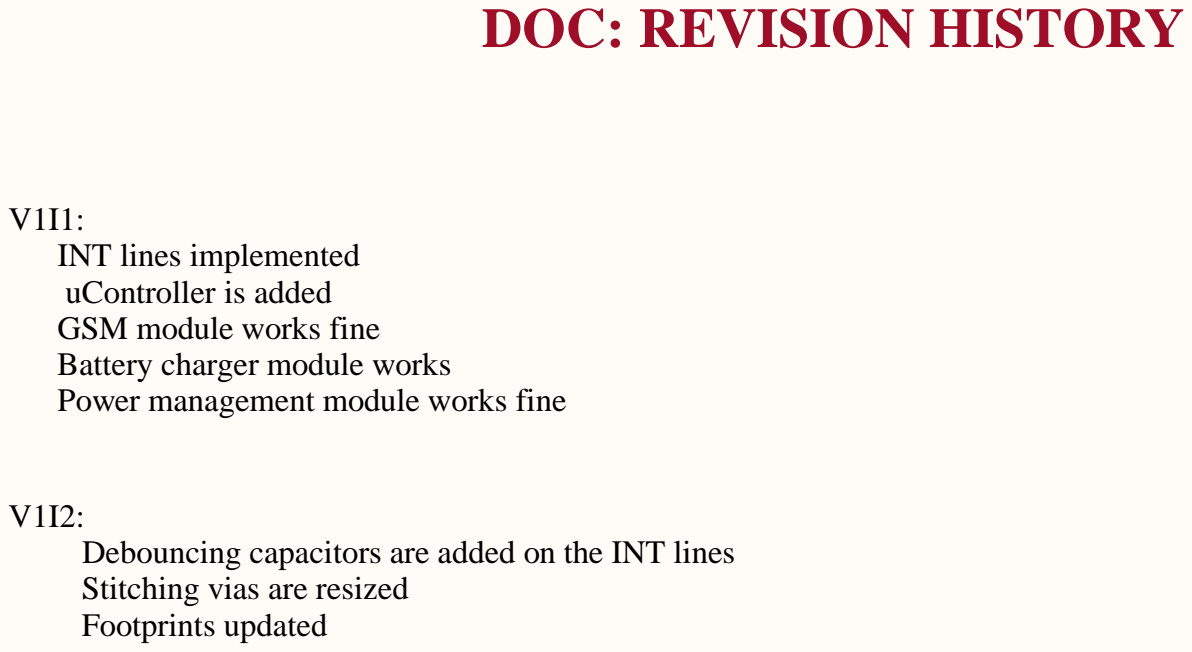
[picture p13: page 6]

INT lines implemented
uController is added
GSM module works fine
Battery charger module works
Power management module works fine

Debouncing capacitors are added on the INT lines
Stitching vias are resized
Footprints updated

CONFIDENTAL. Do not distribute.

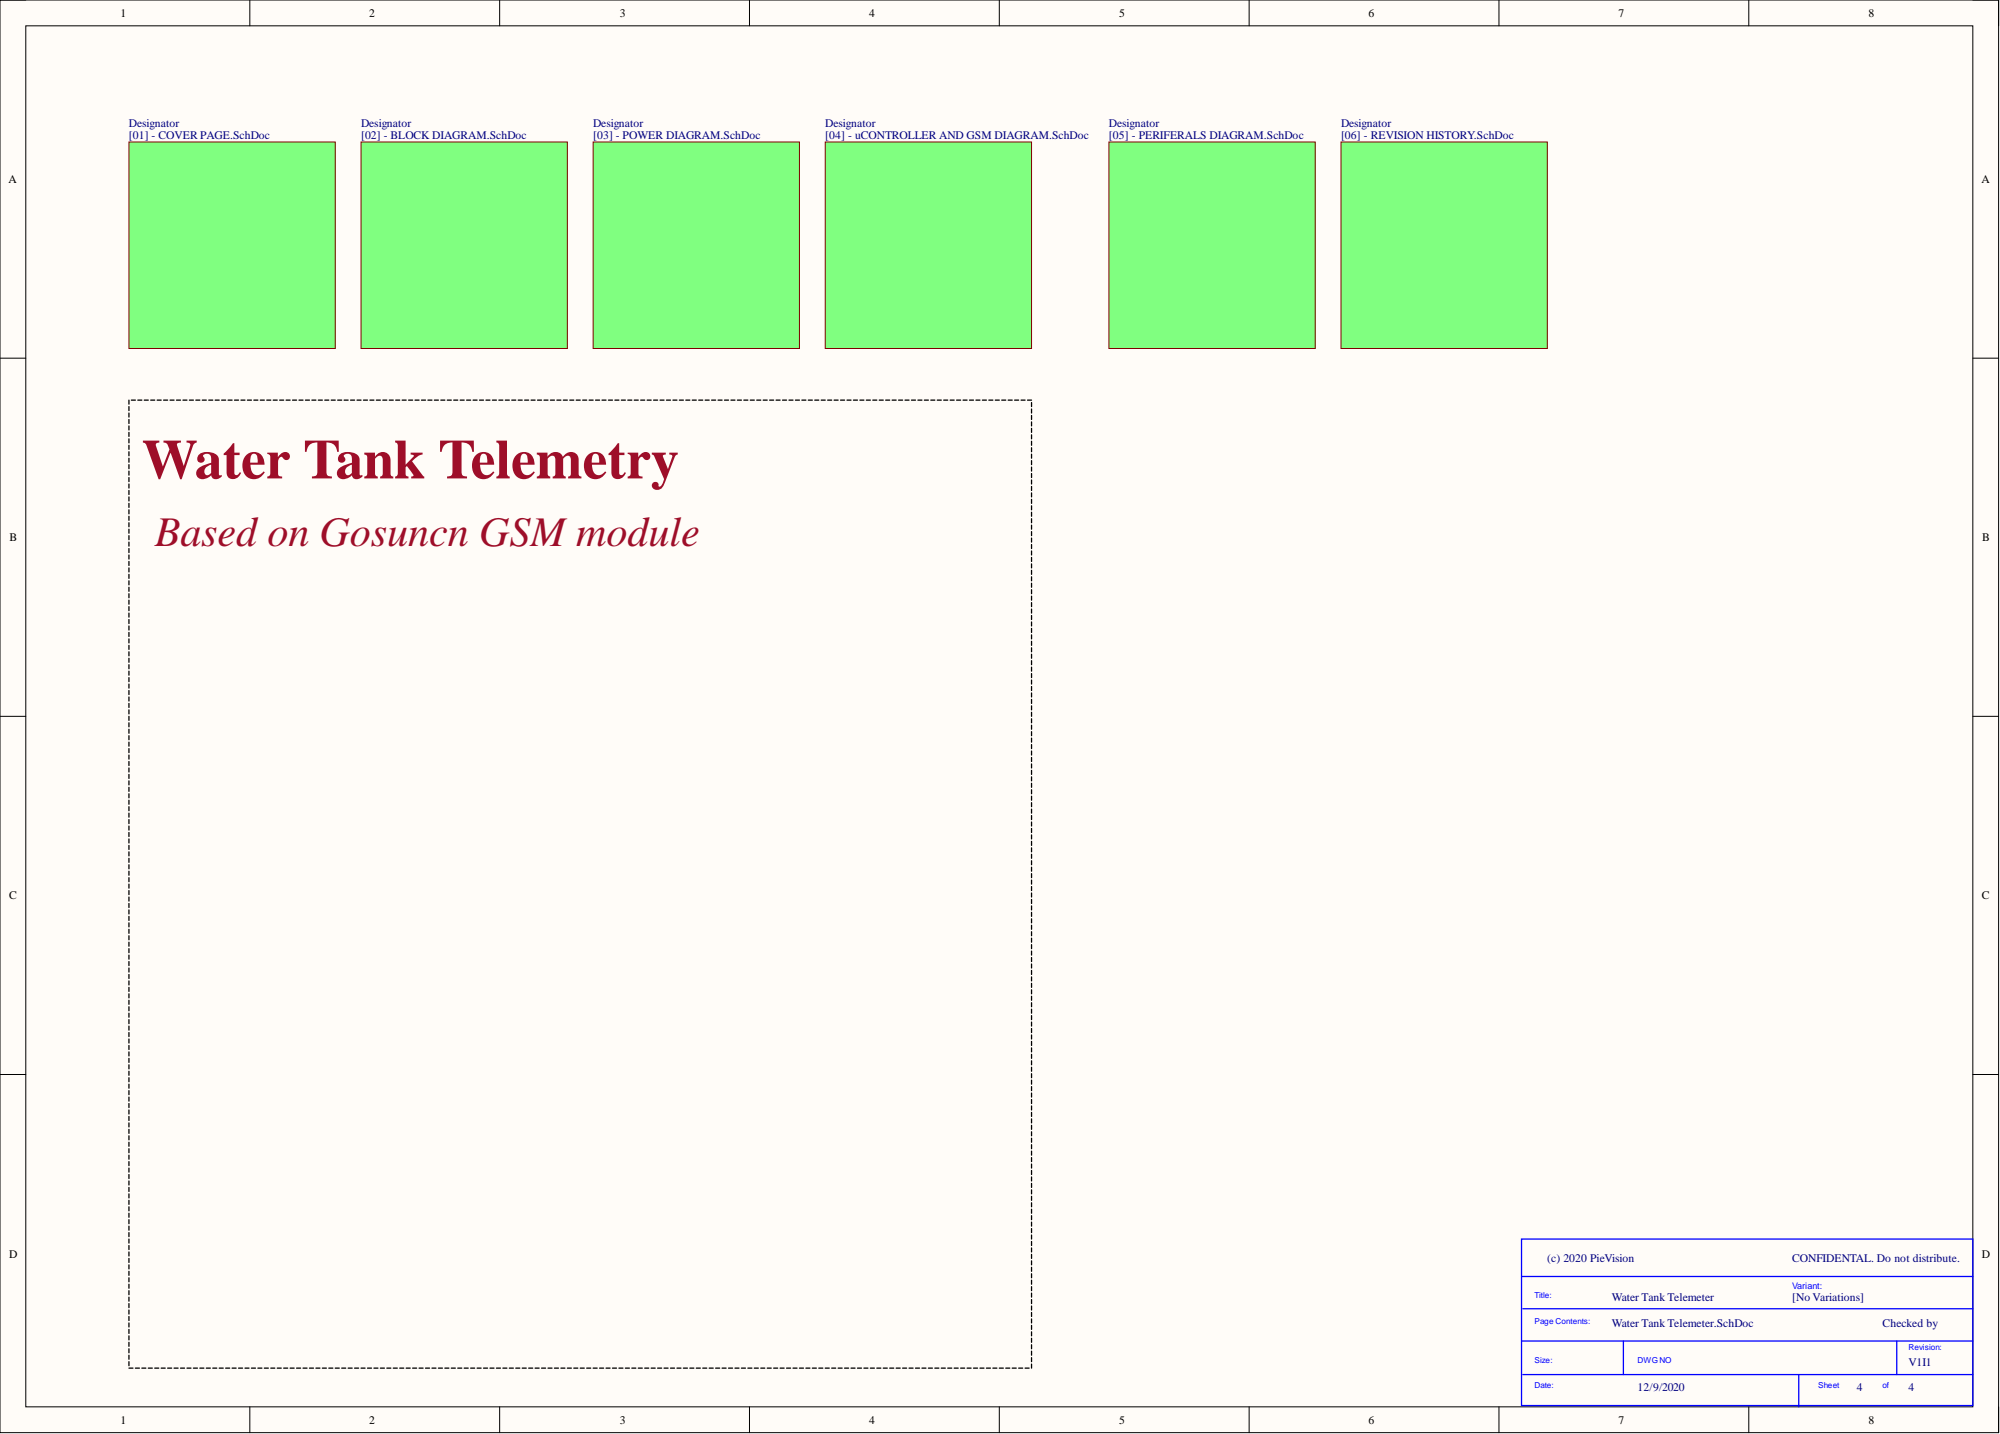
[picture p14: page 7]

Designator
[04] - uCONTROLLER AND GSM DIAGRAM.SchDoc

Based on Gosuncn GSM module

CONFIDENTAL. Do not distribute.

Water Tank Telemeter.SchDoc
