altay-brusan/water-tank-telemeter/(list of files, drawings)

Other design files:
Hardware/Design/[01] - COVER PAGE.SchDoc
Hardware/Design/[02] - BLOCK DIAGRAM.SchDoc
Hardware/Design/[03] - POWER DIAGRAM-backup.SchDoc
Hardware/Design/[03] - POWER DIAGRAM.SchDoc
Hardware/Design/[04] - uCONTROLLER AND GSM DIAGRAM.SchDoc
Hardware/Design/[05] - PERIFERALS DIAGRAM.SchDoc
Hardware/Design/[06] - REVISION HISTORY.SchDoc
Hardware/Design/Water Tank Telemeter.PcbDoc
Hardware/Design/Water Tank Telemeter.PcbLib
Hardware/Design/Water Tank Telemeter.PrjPcb
Hardware/Design/Water Tank Telemeter.SchDoc
Hardware/Design/Water Tank Telemeter.SchLib
