altay-brusan/water-tank-telemeter/Hardware/Design/Firmware/WTT/WTT/Core/Inc/main.h

#define INT0_Pin GPIO_PIN_0
#define INT0_GPIO_Port GPIOA
#define INT0_EXTI_IRQn EXTI0_IRQn
#define INT1_Pin GPIO_PIN_1
#define INT1_GPIO_Port GPIOA
#define INT1_EXTI_IRQn EXTI1_IRQn
#define INT2_Pin GPIO_PIN_4
#define INT2_GPIO_Port GPIOA
#define INT2_EXTI_IRQn EXTI4_IRQn
#define INT3_Pin GPIO_PIN_5
#define INT3_GPIO_Port GPIOA
#define INT3_EXTI_IRQn EXTI9_5_IRQn
#define INT4_Pin GPIO_PIN_6
#define INT4_GPIO_Port GPIOA
#define INT4_EXTI_IRQn EXTI9_5_IRQn
#define MOTOR2_Pin GPIO_PIN_0
#define MOTOR2_GPIO_Port GPIOB
#define MOTOR0_Pin GPIO_PIN_1
#define MOTOR0_GPIO_Port GPIOB
#define MOTOR1_Pin GPIO_PIN_2
#define MOTOR1_GPIO_Port GPIOB
#define INT5_Pin GPIO_PIN_12
#define INT5_GPIO_Port GPIOB
#define INT5_EXTI_IRQn EXTI15_10_IRQn
#define INT6_Pin GPIO_PIN_13
#define INT6_GPIO_Port GPIOB
#define INT6_EXTI_IRQn EXTI15_10_IRQn
#define INT7_Pin GPIO_PIN_14
#define INT7_GPIO_Port GPIOB
#define INT7_EXTI_IRQn EXTI15_10_IRQn
#define GOSUN_PWR_Pin GPIO_PIN_8
#define GOSUN_PWR_GPIO_Port GPIOA
#define LED_Pin GPIO_PIN_12
#define LED_GPIO_Port GPIOA
